pro7it/hexapod/hexapod_rl/IO.md

# Вхід і вихід політики

## Вхід (спостереження): N = 66

| # | Що | Розмір | Індекси | Джерело в MuJoCo | Джерело на реальному роботі |
|---|---|---|---|---|---|
| 1 | Кути суглобів мінус поза стояння | 18 | 0-17 | `qpos[7:]` | енкодер/потенціометр серво |
| 2 | Швидкості суглобів (×0.05) | 18 | 18-35 | `qvel[6:]` | різниця кутів / dt |
| 3 | Вектор гравітації в системі корпусу | 3 | 36-38 | кватерніон `imu_quat` -> поворот `[0,0,-1]` | фільтр (акселерометр + гіроскоп) |
| 4 | Гіроскоп (кутова швидкість корпусу) | 3 | 39-41 | `imu_gyro` | гіроскоп IMU |
| 5 | Попередня дія | 18 | 42-59 | збережена в env | збережена в коді |
| 6 | Контакти стоп (0..1) | 6 | 60-65 | `l1_touch` ... `r3_touch` | кінцеві вимикачі |
| | **Разом** | **66** | | | |

Пізніше, для керованого руху, додається команда швидкості
(vx, vy, yaw rate): +3, тобто N = 69.

Не входить у спостереження (тільки для reward і завершення епізоду):
висота корпусу `qpos[2]`, лінійна швидкість `qvel[0:3]`, позиція x, y.
На реальному роботі їх немає.

## Вихід (дія): 18

| # | Що | Розмір | Діапазон |
|---|---|---|---|
| 1 | Нормалізована зміна цільового кута кожного серво | 18 | [-1, 1] |

Порядок: l1, l2, l3, r1, r2, r3, у кожній нозі coxa, femur, tibia
(як актуатори в `hexapod.xml`).

Перетворення в `step()`:

```
target = clip(target + ACTION_SCALE * action, -1.57, 1.57)   # ACTION_SCALE = 0.03 рад
data.ctrl[:] = target
```

При 50 Гц це до 1.5 рад/с на суглоб.

## Чому не можна просто взяти IMU як кватерніон

1. **Звичайний IMU не дає кватерніон.** Модулі типу MPU6050/MPU6500
   видають лише сирі акселерометр (3) і гіроскоп (3). Кватерніон треба
   обчислювати самому фільтром (Madgwick, Mahony, комплементарний).
   У MuJoCo `imu_quat` це ідеальна істина, якої на залізі не буде.
   Є IMU з вбудованим фьюжном (BNO055, BNO085), але в них свої проблеми
   (див. п. 3).

2. **Кватерніон містить yaw, а політиці він шкідливий.** Напрямок, куди
   дивиться робот у світі, не має впливати на те, як переставляти ноги.
   Якщо подати кватерніон, мережа вчиться залежати від курсу і гірше
   узагальнюється.

3. **Yaw неможливо виміряти без магнітометра.** Гіроскоп інтегрується, і
   yaw дрейфує. Акселерометр визначає тільки нахил і крен (де «низ»).
   Магнітометр у приміщенні та поруч з серво ненадійний. Тому на залізі
   можна надійно знати лише гравітацію, а не повну орієнтацію.

4. **Подвійне покриття.** Кватерніони `q` і `-q` описують той самий
   поворот, тож однакова поза може давати різні входи. Для нейромережі
   це розрив у даних (стрибки знака).

5. **Акселерометр під час руху шумний.** Він вимірює гравітацію плюс
   прискорення корпусу. Походка дає вібрації, тому сирий акселерометр як
   «напрямок гравітації» брехливий, і потрібен фільтр. У симуляторі варто
   додати такий шум до гравітації, щоб політика не звикла до ідеалу.

**Рішення:** подавати вектор гравітації в системі корпусу (3 числа).
Він показує нахил і крен, не залежить від yaw, не має подвійного
покриття і оцінюється на залізі з акселерометра та гіроскопа.

Обчислення в симуляторі:

```
q = data.sensordata[<адреса imu_quat>]   # w, x, y, z
q_inv = mju_negQuat(q)
g_body = mju_rotVecQuat([0, 0, -1], q_inv)
```
