pro7it/hexapod/references/details.md

| Категорія | Товар | К-сть | Ціна (прибл.) | Навіщо саме тобі |
| --- | --- | --- | --- | --- |
| Мозок (основний) | Raspberry Pi 4 (4GB) | 1 | $85-100 | Веб-сервер, Python-код керування, база під ROS2 у майбутньому |
| Карта пам'яті | microSD 32GB, клас A1/A2 | 1 | $8-10 | ОС для Pi (Raspberry Pi OS / Ubuntu Server) |
| Драйвер серво | PCA9685 16-channel I2C PWM | 2 | ~$9-10/шт ($18-20) | Генерує стабільний PWM для 18 серв — Pi сам на таке не здатен |
| АЦП для сенсорів | ADS1115 4-channel I2C ADC | 1 | $8-10 | Обов'язково, бо Pi не має аналогових пінів |
| Струм/напруга | ACS712 30A + Voltage Sensor DC0-25V | 1 (набір)  | $12 | Моніторинг споживання і напруги батареї з коду |
| Лімсвічі | Micro Limit Switch (30 шт, потрібно 6) | 1 упаковка | $4.99 | Кінцевики ходу ніг, йдуть у надруковану деталь micro-switch-tip |
| Дроти | Dupont F-F 120 шт | 4 | $6.98 | I2C, GPIO, живлення сенсорів |
| Сервоприводи | ZOSKAY 35kg High Torque | 18 | ~$18-20/шт (~$330-360) | Виконавчі механізми всіх 18 суглобів |
| Тестер сервоприводів | ACOSUN Digital Servo Tester | 1 | $12.99 | Калібрування кожної з 18 однакових серв перед збіркою |
| Батарея для тестера | NiMH 4.8V 2000mAh | 1 | $11.99 | Живлення тестера окремо від головної батареї |
| Батарея | Zeee 7.4V 60C 6200mAh 2S LiPo | 1 | ~$22 | Живлення сервоприводів |
| Понижувач напруги | DC-DC buck converter 7.4V→5V, 3A+ | 1 | $7-10 | Живлення Pi від тієї ж батареї — 7.4V напряму спалить плату |
| Вимикач | Mini Toggle Switch SPST (набір 10 шт)  | 1 | $9.99 | Головний вимикач живлення |
| Силовий роз'єм | Deans/T-plug (5 пар) | 1 | $8.99 | Стандартний конектор під LiPo |
| Зарядка | Tenergy TB6-B Balance Charger | 1 | $57.99 | Безпечна зарядка LiPo 2S через баланс-роз'єм |
| Гумові наконечники | Rubber tips (5/16", 15мм) | 6 | $7.49 | Наконечники стоп |
| Дюбелі-обмежувачі | Dowel pins 2×22мм (100 шт, потрібно 6) | 1 упаковка | $6.59 | Механічні обмежувачі ходу в деталі limiter |
| Гвинти для 3D-деталей  | M1.6×6мм (100 шт, потрібно 120) | 2 упаковки | $15.74 | Кріплення надрукованих частин |
| Гвинти для плат | M2.5×6мм (100 шт, потрібно 4) | 1 упаковка | $10.99 | Кріплення PCA9685/ADS1115 |
| Суперклей | Gorilla Super Glue Gel | 1 | $6.84 | Фіксація дюбелів-обмежувачів |
| Маркери | Sharpie metallic fine point | 1 | $3.48 | Мітки на сервоприводах під час калібрування |
| Паяльник | Soldering Iron Kit 60W | 1 | $22.99 | Пайка вимикача, силових проводів |
| Термофен (опціонально) | Heat gun | 1 | $21.22 | Термоусадка на з'єднаннях |
| LiDAR | RPLidar A1 | 1 | ~$100 | SLAM — побудова карти, виявлення перешкод для Nav2 |
| IMU | BNO055 (I2C) | 1 | ~$12 | Орієнтація тіла |
