pro7it/hexapod/references/3dparts.md

| Part | Description | Amount | File |
| --- | --- | --- | --- |
| battery bar | hold battery | 2 | `battery-bar.stl` |
| bottom cover | hold all electronics  | 1 | `bottom-cover.stl` |
| frame | the holding one | 1 | `frame.stl` |
| top cover | close the electronics | 1 | `top-cover.stl` |
| left coxa | leg component | 3 | `left-coxa.stl` |
| right coxa | leg component | 3 | `right-coxa.stl` |
| left femur | leg component | 3 | `left-femur.stl` |
| right femur | leg component | 3 | `right-femur.stl` |
| left tibia | leg component | 3 | `left-tibia.stl` |
| right tibia | leg component | 3 | `right-tibia.stl` |
| limiter | leg component | 6 | `limiter.stl` |
| micro switch tip | leg component | 6 | `micro-switch-tip.stl`  |
| tip | leg component | 6 | `tip.stl` |
| servo back hole  | leg component | 18 | `servo-back-hole.stl` |
| shield | leg protection | 6 | `shield.stl` |
| calibrator arm | check servo | 1 | `calibration-arm.stl` |
| calibrator ruler | check servo | 1 | `calibration-ruler.stl` |
