pro7it/hexapod/model_report.md

# Гексапод: RL-модель ходи (stage3.3-sway)

*Станом на 2 листопада 2026*

Модель stage3.3-sway — нейромережева політика, навчена методом PPO. Вона керує 18 суглобами гексапода в симуляторі MuJoCo і ходить триногою вперед зі швидкістю 0.18 м/с. Заданий курс робот тримає з похибкою 0.15°, а вбік майже не зсувається (−0.6 см на метр). Політику навчено з нуля за 5 млн кроків симуляції лише через нагороди і штрафи, без заданої наперед траєкторії ніг.

Файли моделі: `hexapod_rl/models/stage3.3-sway/model.zip` і `vecnormalize.pkl` (статистика нормалізації спостережень).

## Задача і симуляція

| параметр | значення |
| --- | --- |
| робот | гексапод, 6 ніг × 3 суглоби (coxa, femur, tibia) = 18 ступенів свободи |
| маса моделі | 2.23 кг |
| симулятор | MuJoCo, крок фізики 2 мс |
| приводи | позиційні: kp = 20, kv = 0.5, момент до ±3.4 Н·м, діапазон суглобів ±45° |
| частота керування | 50 Гц (10 кроків фізики на одну дію) |
| епізод | 1000 кроків = 20 с; завершується, якщо корпус нижче 5 см або перевернувся |
| середовище | Gymnasium; код: `hexapod_rl/hexapod_env.py`, параметри: `hexapod_rl/config.py` |

## Спостереження і дії

**Спостереження: 45 чисел.**

| частина | розмір | опис |
| --- | --- | --- |
| кути суглобів | 18 | відхилення від стійки (STAND_POSE) |
| швидкості суглобів | 18 | × 0.05 |
| вектор гравітації в осях корпусу | 3 | нахил корпусу (IMU) |
| кутова швидкість корпусу | 3 | гіроскоп (IMU) |
| фаза ходи | 2 | sin і cos фази, генератор ритму 1.5 Гц |
| похибка курсу | 1 | заданий курс мінус поточний, у радіанах |

Спостереження нормалізуються ковзним середнім і дисперсією (VecNormalize) з обрізанням до ±10.

**Дія: 18 чисел у [−1, 1].** Кожне задає зсув кута суглоба від стійки до ±0.5 рад. Перед подачею на приводи ціль згладжується фільтром нижніх частот:

```latex
\theta_t = 0.8\,\theta_{t-1} + 0.2\,(\theta_{stand} + 0.5\,a_t)
```

**Фаза** не задає рух ніг, а лише дає мережі «годинник» ритму. Нагорода за ходу перевіряє, чи стопи торкаються землі за розкладом триноги: тринога A (l1, r2, l3) стоїть, коли sin фази > 0, тринога B (r1, l2, r3) — навпаки.

**Курс:** при кожному скиданні ціль = стартовий курс + випадковий зсув до ±15°, тож модель вчиться і довертати на курс, і тримати його.

## Нагорода

Нагорода на кожному кроці — зважена сума 12 термів.

| терм | вага | що вимірює | навіщо |
| --- | --- | --- | --- |
| r_vel | +2.0 | швидкість уперед / 0.15 м/с, обрізано до [−1, 1] | основна мета; стеля прибирає «вібраційний» розгін |
| r_gait | +1.0 | частка ніг, чий контакт із землею збігається з розкладом триноги | ритм триноги |
| r_heading | +1.0 | exp(−Δψ² / 0.0076), σ ≈ 5° | тримати заданий курс |
| r_vy | +1.0 | exp(−v̄y² / 0.0001), бічна швидкість, усереднена за цикл | не рухатися крабом |
| r_air | +1.0 | при приземленні: час у повітрі − 0.2 с (до 0.5 с) | справжні кроки замість дрібного тупцювання |
| pen_roll | −100 | квадрат нахилу корпусу вбік | рівний корпус |
| pen_pitch | −30 | квадрат нахилу корпусу вперед-назад | рівний корпус |
| pen_stroke | −20 | раз на півцикл: дисперсія довжини ходу 6 стоп навколо середнього | усі шість ніг крокують однаково |
| pen_angvel | −2 | ωx² + ωy² + ωz² корпусу | без хитання і виляння |
| pen_vy | −20 | бічна швидкість² на кожному кроці | без розгойдування вліво-вправо |
| pen_vz | −50 | вертикальна швидкість² | без підскакування |
| pen_rate | −0.05 | Σ(aₜ − aₜ₋₁)² | плавні дії, без вібрації |

Окремі терми з'являлися у відповідь на конкретні обхідні шляхи, які знаходив PPO: рух за рахунок вібрації (r_vel зі стелею, pen_rate, r_air), ходьба на кількох ногах, поки решта відпочиває (pen_stroke), дрейф курсу (r_heading), рух крабом (r_vy, pen_vy).

## Навчання

| параметр | значення |
| --- | --- |
| алгоритм | PPO (Stable-Baselines3), MlpPolicy |
| мережі | актор і критик окремі, по два шари 256 нейронів |
| паралельні середовища | 4 |
| n_steps / batch_size / n_epochs | 1024 / 2048 / 5 |
| γ / λ (GAE) / clip | 0.99 / 0.95 / 0.2 |
| швидкість навчання | 3·10⁻⁴ → 3·10⁻⁵ лінійно за перші 3 млн кроків, далі стала 3·10⁻⁵ |
| дослідження | log_std_init = −1, ent_coef = 0 |
| тривалість | 3 млн кроків з нуля + 2 млн донавчання = 5 млн (≈ 28 год симульованого часу) |

## Результати

Оцінка без шуму дій (deterministic), 6 запусків по 20 с:

| метрика | значення |
| --- | --- |
| швидкість уперед | 0.179 м/с |
| довертання з похибки курсу до 15° | 0.4 с |
| похибка курсу після довертання | 0.15° (максимум 0.4°) |
| бічний зсув | −0.6 см на метр |
| нахил корпусу вбік (roll) | ±0.15° |
| виляння (ωz) | ±0.041 рад/с |
| хода | тринога з ритмом 1.5 Гц; контакт стоп збігається з розкладом у 88% випадків |

Тест на стійкість (ті самі метрики, 3 запуски на умову, жодного падіння):

| умова | швидкість, м/с | похибка курсу після 5 с |
| --- | --- | --- |
| номінальна | 0.179 | 0.15° |
| тертя × 0.6 | 0.170 | 0.18° |
| тертя × 1.4 | 0.055 | 0.59° |
| маса корпусу × 1.3 | 0.177 | 0.14° |
| маса корпусу × 0.8 | 0.180 | 0.16° |
| поштовх убік 25 Н, 0.1 с | 0.178 | 0.18° |
| поштовх назад 25 Н, 0.1 с | 0.174 | 0.18° |

## Обмеження і наступні кроки

- **Шаркання.** Стопи піднімаються лише на 3–6 мм, а 12% часу в «повітряній» фазі торкаються землі. Через це на липкішій підлозі (тертя × 1.4) швидкість падає втричі. План: нагорода за підйом ноги і випадкове тертя під час навчання.
- **Датчики справжнього робота.** На роботі стоять PWM-сервоприводи без зворотного зв'язку, тож фактичних кутів і швидкостей суглобів у спостереженні не буде. Наступна версія вчиться на скомандованих кутах і попередній дії замість них (у роботі). Далі в планах контакти стоп від кінцевиків.
- **Перенесення на залізо.** Потрібно заміряти динаміку серво, додати затримки, шум IMU і випадкові зміни маси й тертя.
- **Команди.** Наступний етап — керування швидкостями (vx, vy, ω) замість фіксованого руху вперед.
