pro7it/hexapod/hexapod_rl/model/meshes/right-femur.stl

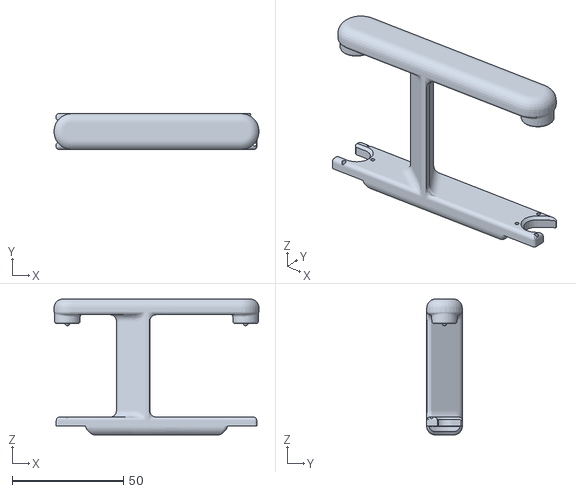
[picture p1: CAD file, 2026-11-04]
hexapod_rl/model/meshes/right-femur.stl
92.0 x 16.0 x 61.0
