pro7it/hexapod/hexapod_ws/src/hexapod_description/meshes/left-coxa.stl

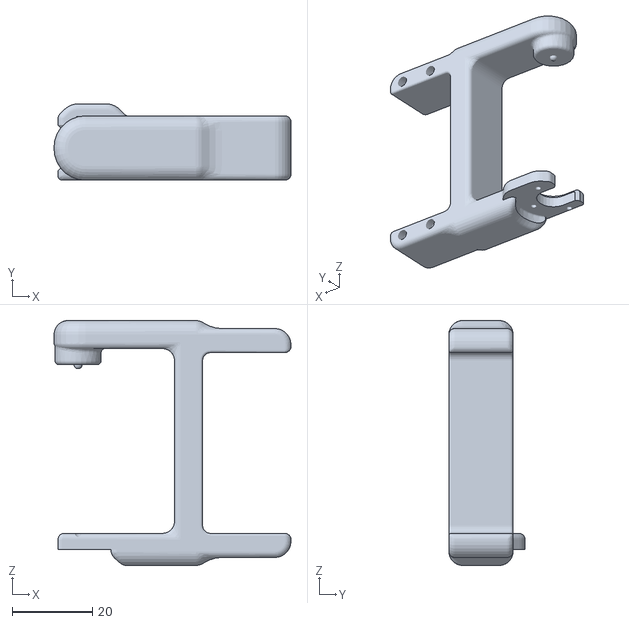
[picture p2: CAD file, 2026-11-04]
hexapod_ws/src/hexapod_description/meshes/left-coxa.stl
59.0 x 19.0 x 61.0
