pro7it/hexapod/references/stl/limiter.stl

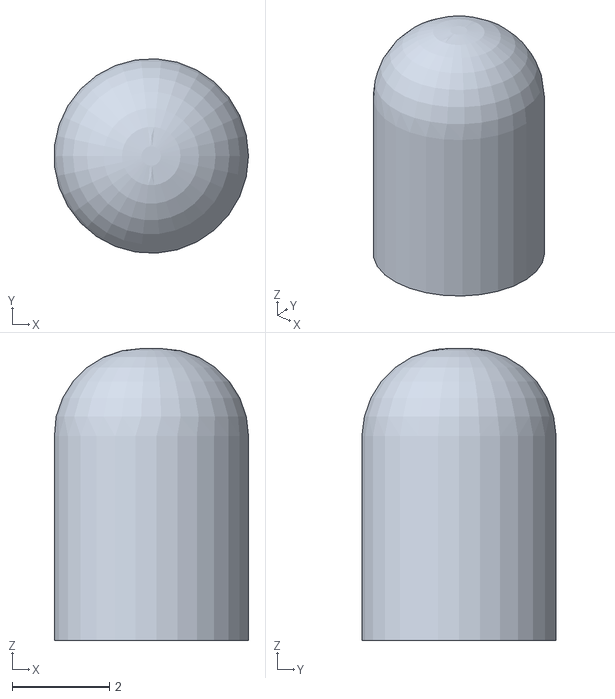
[picture p3: CAD file, 2026-09-18]
references/stl/limiter.stl
3.99 x 3.99 x 6.00
