pro7it/hexapod/stl_decimate/top-cover.stl

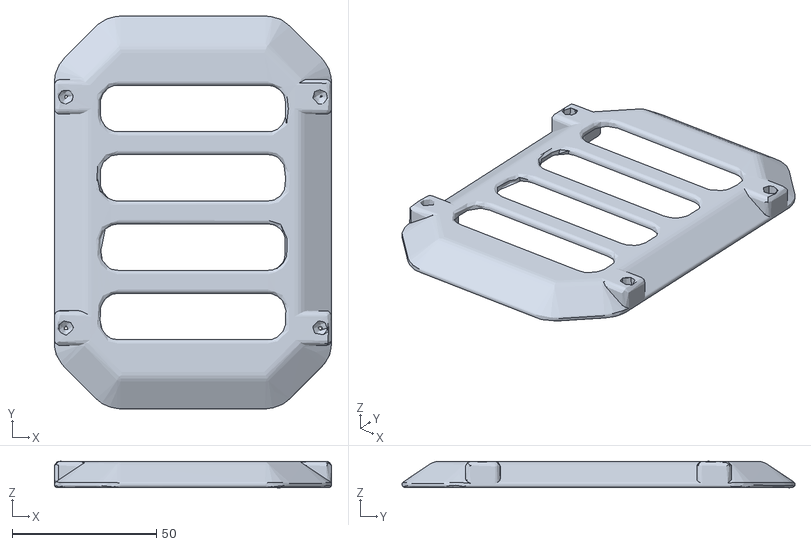
[picture p4: CAD file, 2026-10-15]
stl_decimate/top-cover.stl
96.0 x 136.0 x 9.21
