pro7it/hexapod/hexapod_ws/src/hexapod_description/meshes/right-coxa-collision.stl

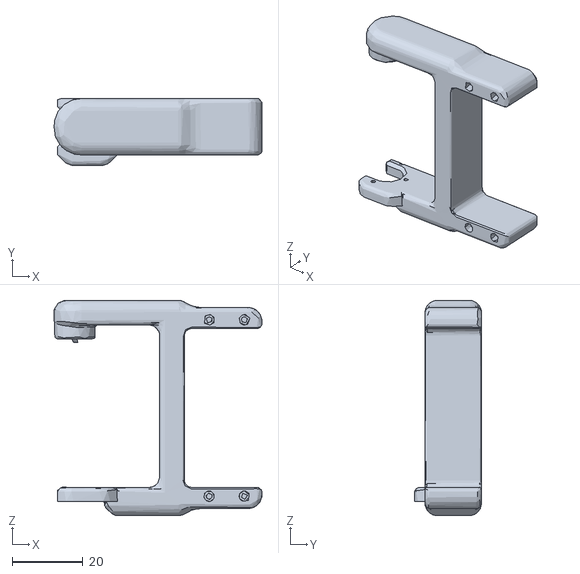
[picture p5: CAD file, 2026-11-04]
hexapod_ws/src/hexapod_description/meshes/right-coxa-collision.stl
58.9 x 19.0 x 61.0
