pro7it/hexapod/references/stl/left-coxa.stl

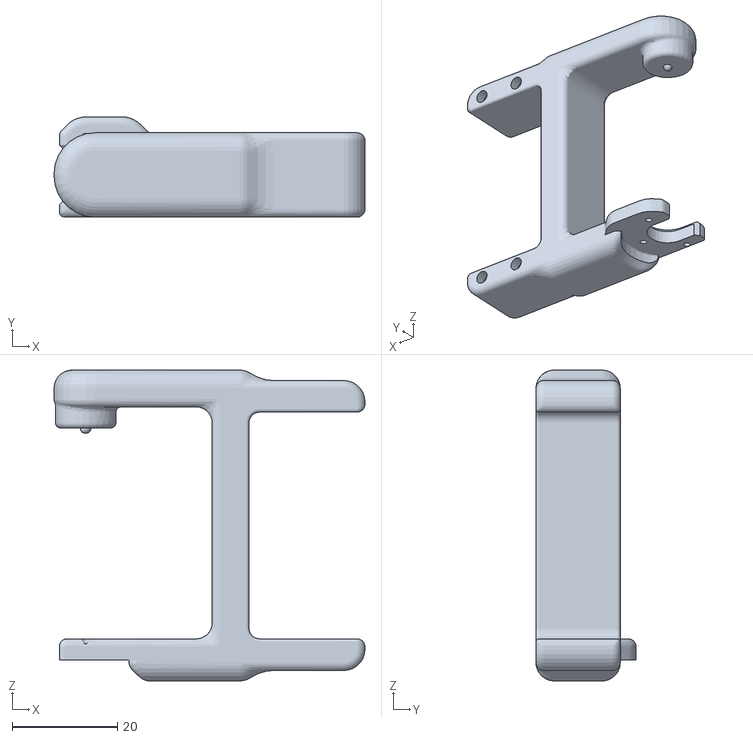
[picture p6: CAD file, 2026-09-18]
references/stl/left-coxa.stl
59.0 x 19.0 x 59.0
