pro7it/hexapod/stl_decimate/servo-back-hole.stl

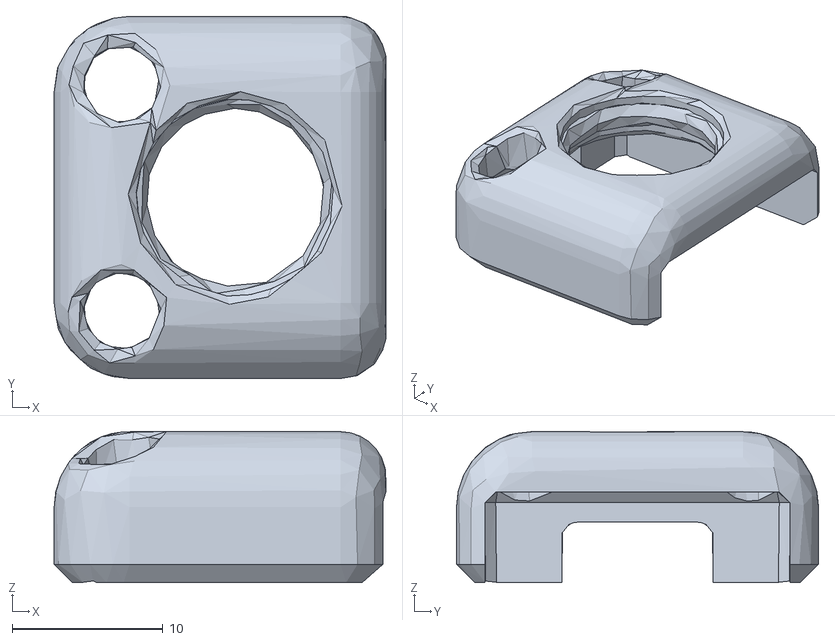
[picture p7: CAD file, 2026-10-15]
stl_decimate/servo-back-hole.stl
22.0 x 24.0 x 10.0
