pro7it/hexapod/references/stl/shield.stl

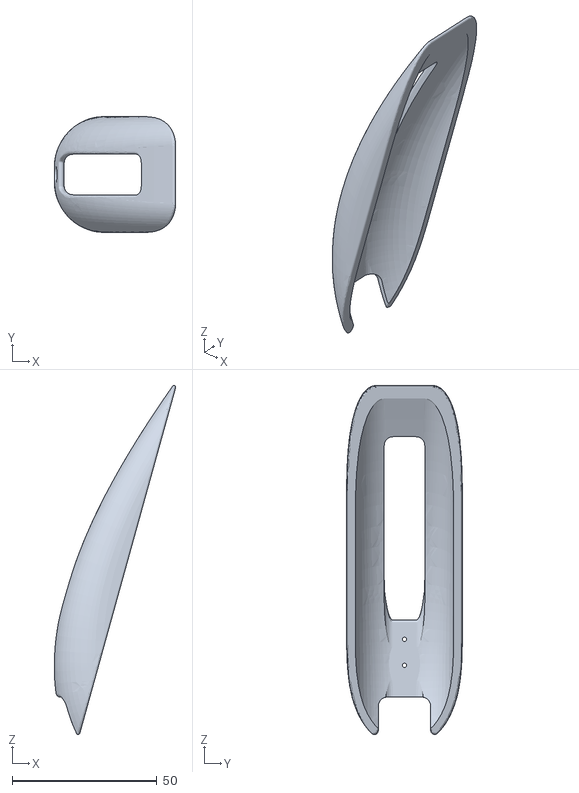
[picture p8: CAD file, 2026-09-18]
references/stl/shield.stl
42.0 x 40.0 x 120.6
