pro7it/hexapod/stl_decimate/right-femur.stl

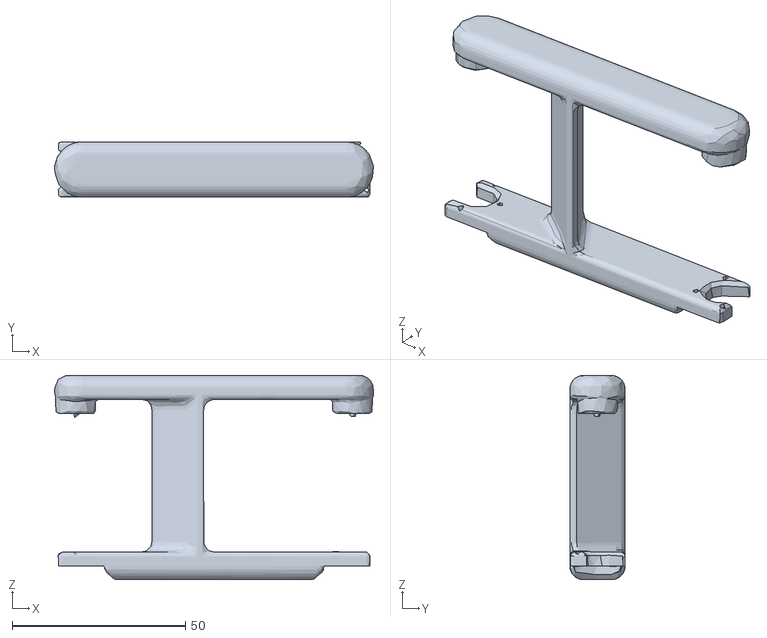
[picture p9: CAD file, 2026-10-15]
stl_decimate/right-femur.stl
92.1 x 16.0 x 59.0
