pro7it/hexapod/hexapod_ws/src/hexapod_description/meshes/tip-collision.stl

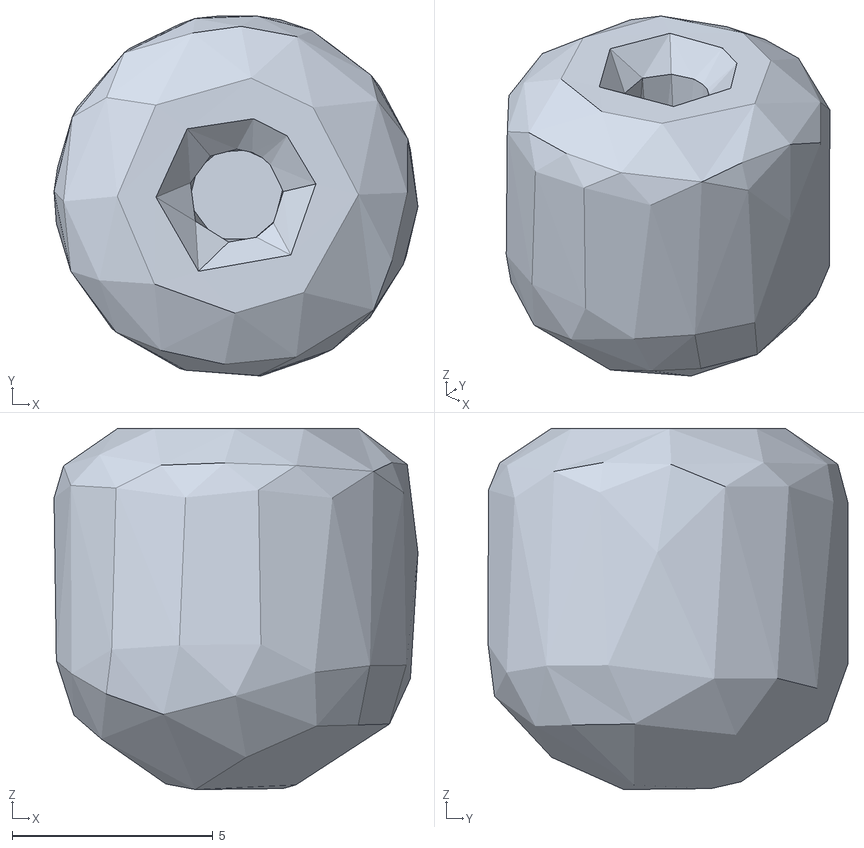
[picture p10: CAD file, 2026-10-15]
hexapod_ws/src/hexapod_description/meshes/tip-collision.stl
9.06 x 8.96 x 8.99
