pro7it/hexapod/references/stl/micro-switch-tip.stl

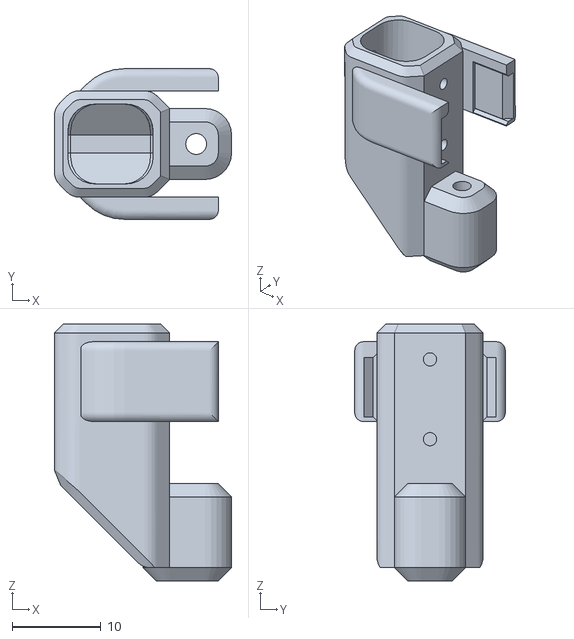
[picture p11: CAD file, 2026-09-18]
references/stl/micro-switch-tip.stl
20.0 x 17.0 x 29.0
