pro7it/hexapod/stl_decimate/right-tibia.stl

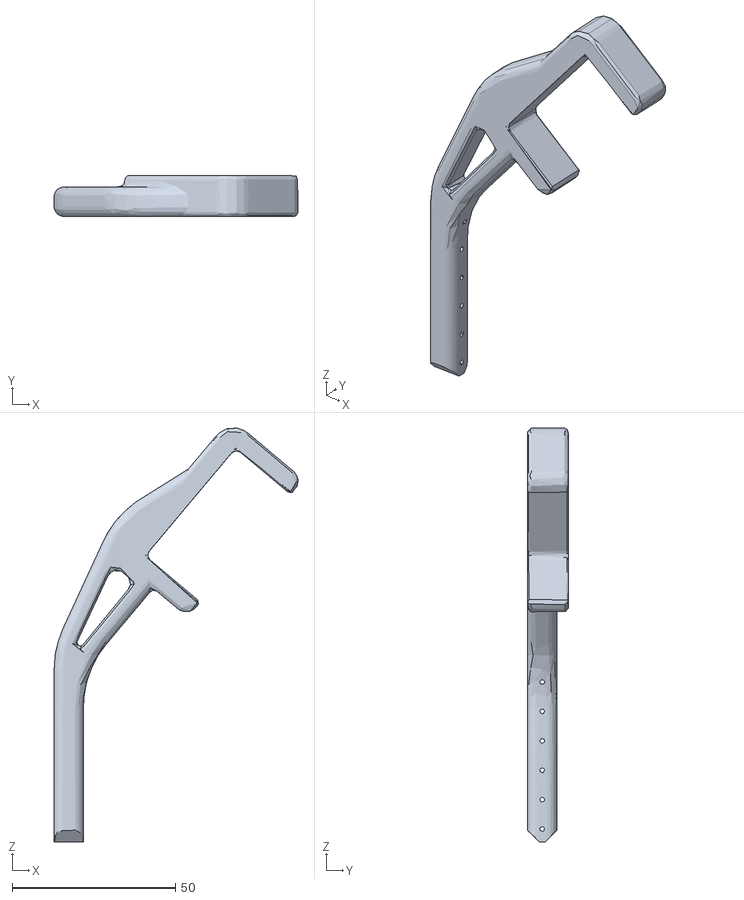
[picture p12: CAD file, 2026-10-15]
stl_decimate/right-tibia.stl
74.6 x 12.5 x 126.7
