pro7it/hexapod/hexapod_ws/src/hexapod_description/meshes/micro-switch-tip-collision.stl

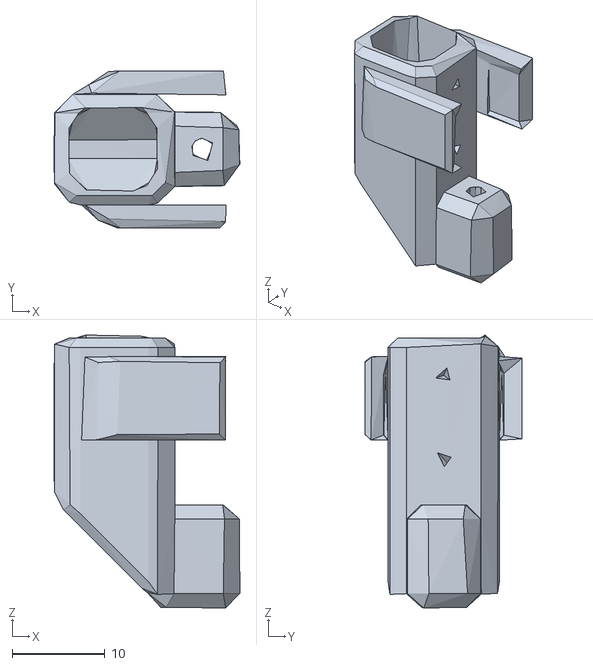
[picture p13: CAD file, 2026-10-15]
hexapod_ws/src/hexapod_description/meshes/micro-switch-tip-collision.stl
20.0 x 16.9 x 29.4
