pro7it/hexapod/references/stl/tip.stl

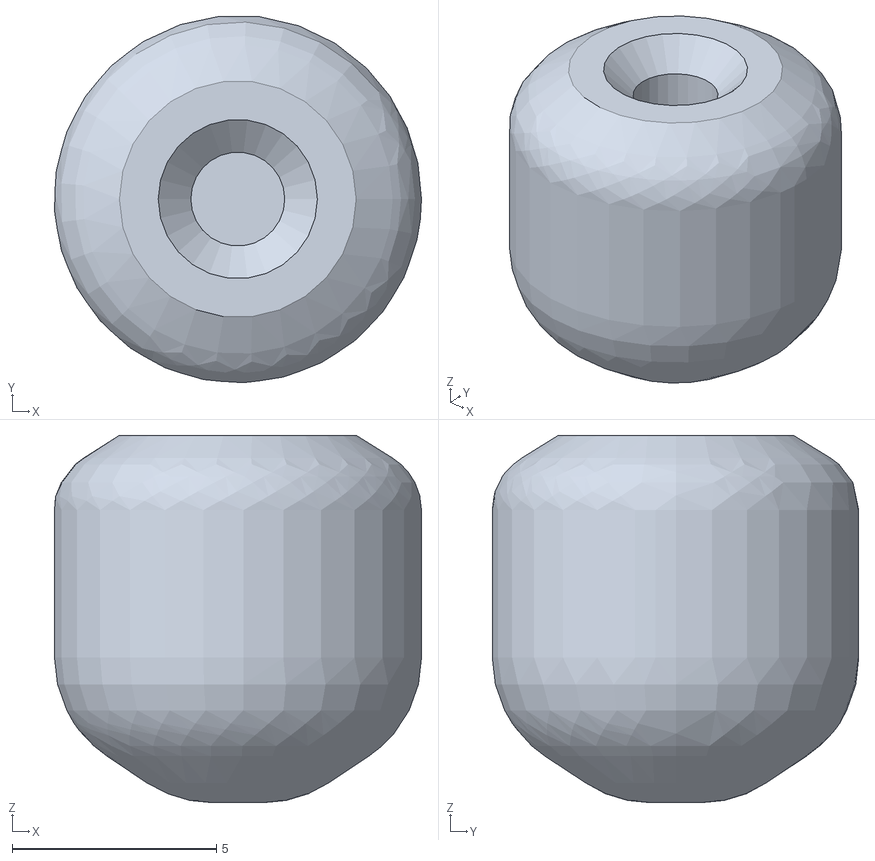
[picture p14: CAD file, 2026-09-18]
references/stl/tip.stl
8.99 x 8.98 x 9.00
