pro7it/hexapod/stl_decimate/calibration-ruler.stl

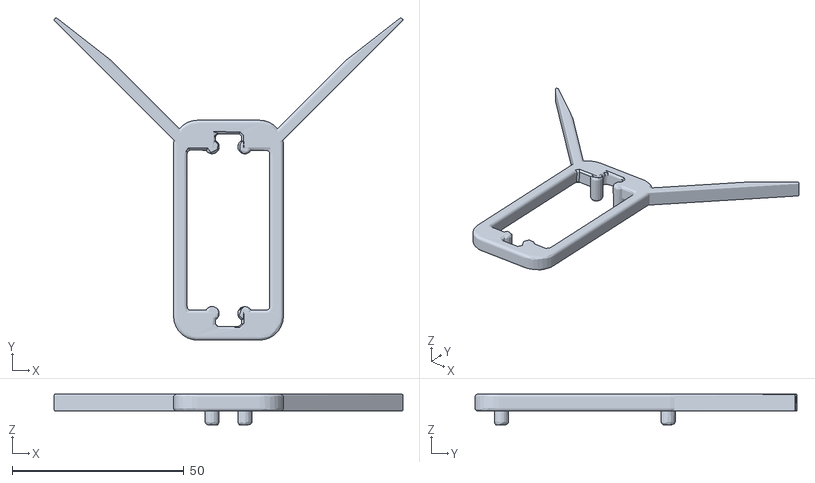
[picture p15: CAD file, 2026-10-15]
stl_decimate/calibration-ruler.stl
101.5 x 93.8 x 9.01
