pro7it/hexapod/hexapod_ws/src/hexapod_description/meshes/battery-bar-collision.stl

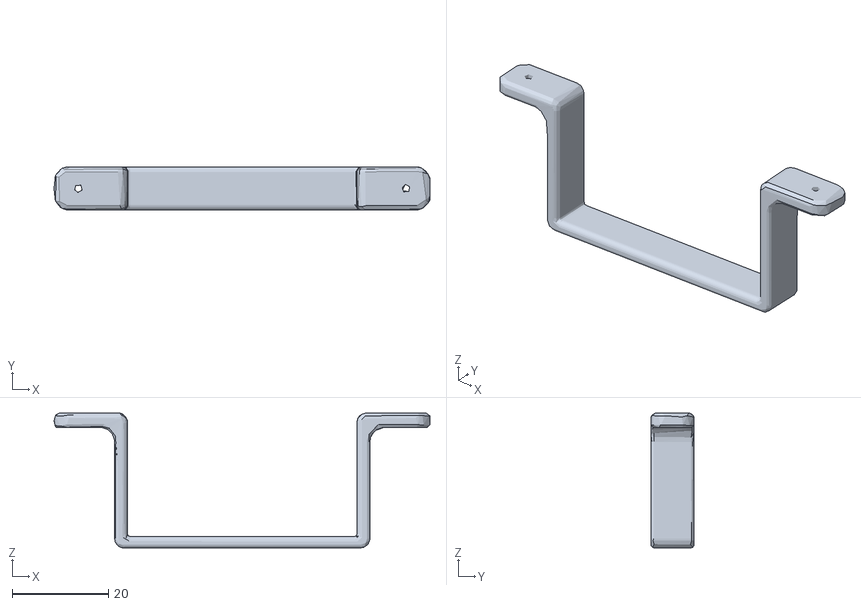
[picture p16: CAD file, 2026-10-15]
hexapod_ws/src/hexapod_description/meshes/battery-bar-collision.stl
78.0 x 9.00 x 28.0
