pro7it/hexapod/hexapod_ws/src/hexapod_description/meshes/frame-collision.stl

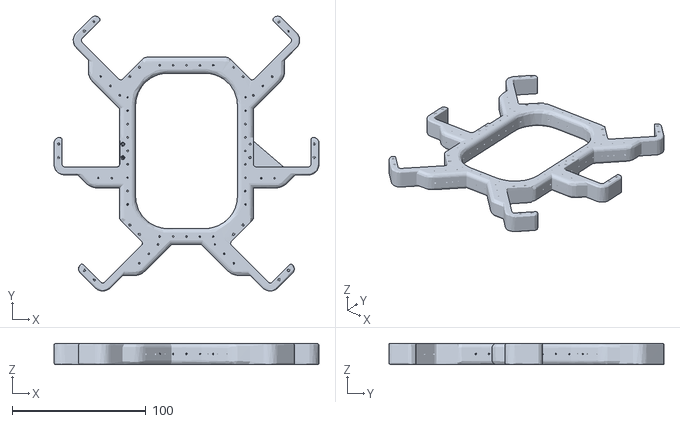
[picture p17: CAD file, 2026-10-15]
hexapod_ws/src/hexapod_description/meshes/frame-collision.stl
198.0 x 205.4 x 16.0
