pro7it/hexapod/stl_decimate/calibration-arm.stl

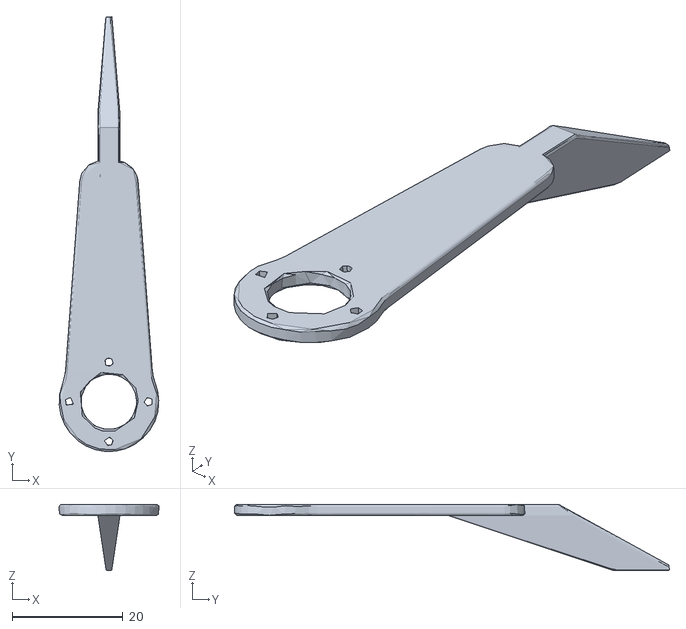
[picture p18: CAD file, 2026-10-15]
stl_decimate/calibration-arm.stl
18.0 x 78.5 x 12.0
