pro7it/hexapod/hexapod_ws/src/hexapod_description/meshes/bottom-cover-collision.stl

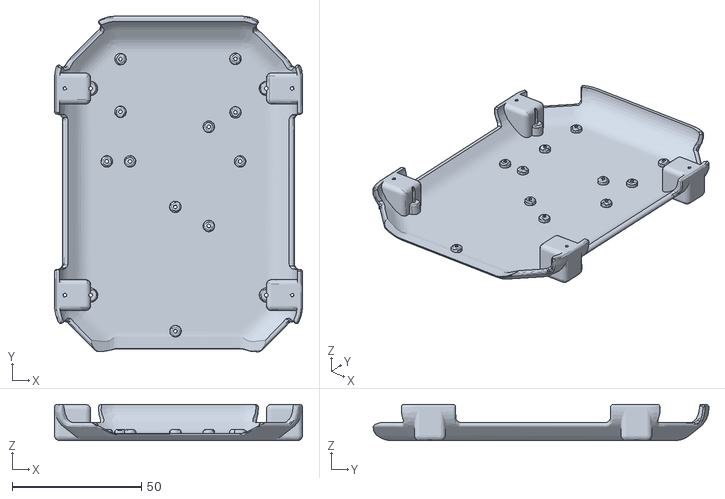
[picture p19: CAD file, 2026-10-15]
hexapod_ws/src/hexapod_description/meshes/bottom-cover-collision.stl
96.0 x 130.0 x 14.0
