pro7it/hexapod/references/stl/top-cover.stl

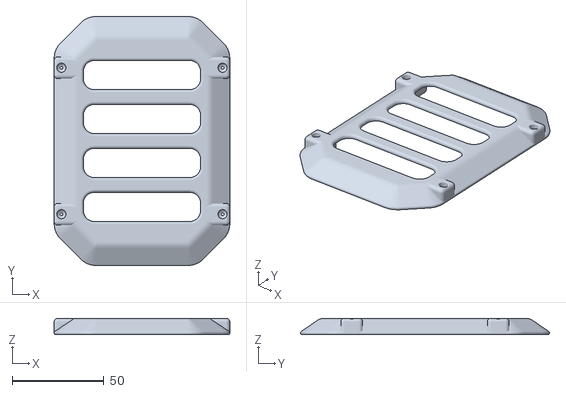
[picture p20: CAD file, 2026-09-18]
references/stl/top-cover.stl
96.0 x 136.0 x 9.00
