pro7it/hexapod/references/stl/frame.stl

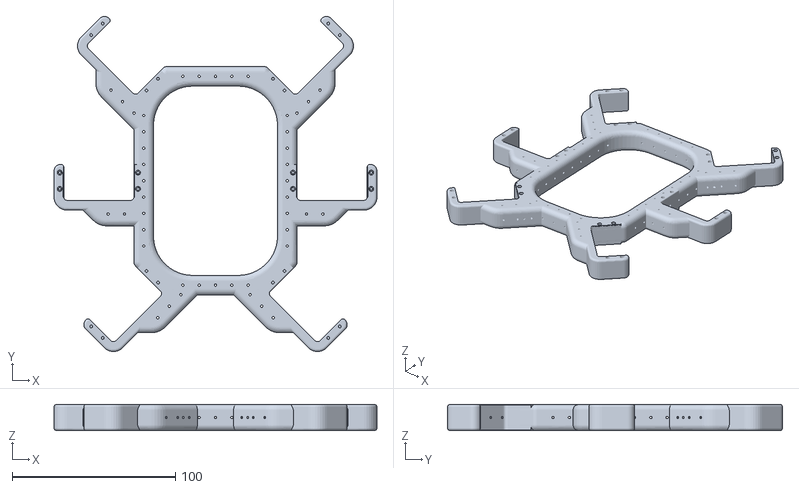
[picture p21: CAD file, 2026-09-18]
references/stl/frame.stl
198.0 x 205.4 x 16.0
