pro7it/hexapod/references/stl/calibration-arm.stl

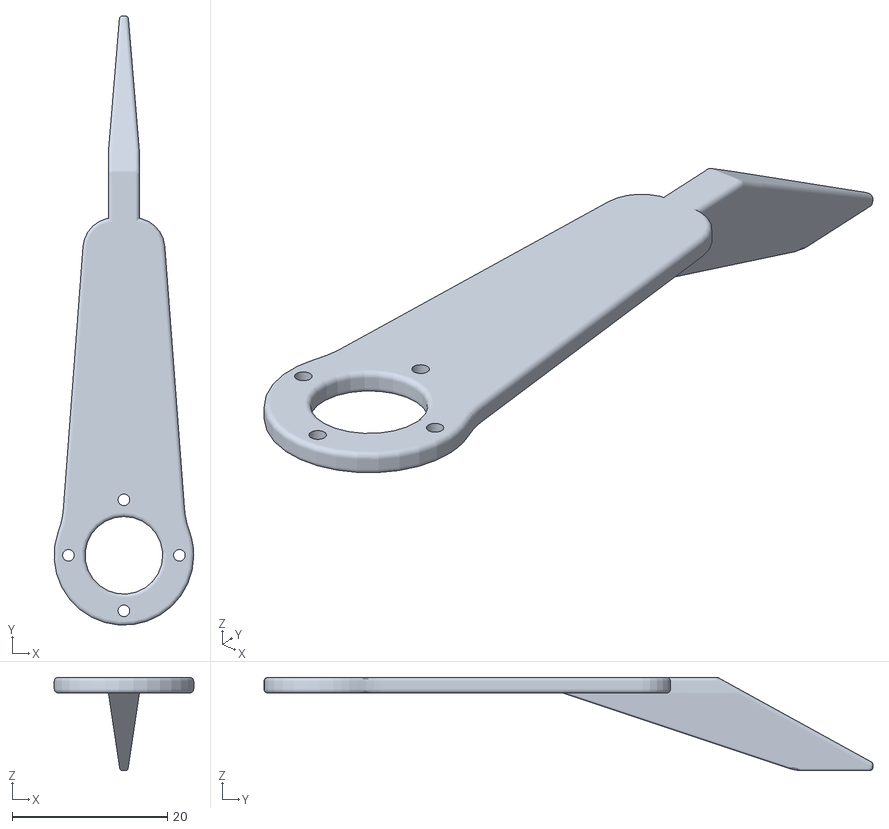
[picture p22: CAD file, 2026-09-18]
references/stl/calibration-arm.stl
18.0 x 78.5 x 12.0
