pro7it/hexapod/(list of files, cad)

Other CAD files:
stl/left-femur.stl
hexapod_rl/model/meshes/right-coxa.stl
hexapod_ws/src/hexapod_description/meshes/right-femur-collision.stl
hexapod_ws/src/hexapod_description/meshes/left-femur-collision.stl
references/stl/right-femur.stl
stl_decimate/shield.stl
hexapod_ws/src/hexapod_description/meshes/left-coxa-collision.stl
references/stl/right-coxa.stl
stl_decimate/limiter.stl
references/stl/left-femur.stl
stl_decimate/left-coxa.stl
references/stl/left-tibia.stl
references/stl/servo-back-hole.stl
hexapod_ws/src/hexapod_description/meshes/left-tibia-collision.stl
references/stl/right-tibia.stl
references/stl/calibration-ruler.stl
references/stl/bottom-cover.stl
references/stl/battery-bar.stl
