pro7it/hexapod/hexapod_rl/model/hexapod.urdf

<?xml version="1.0" ?>
<!-- =================================================================================== -->
<!-- |    This document was autogenerated by xacro from hexapod_ws/src/hexapod_description/urdf/hexapod.urdf.xacro | -->
<!-- |    EDITING THIS FILE BY HAND IS NOT RECOMMENDED                                 | -->
<!-- =================================================================================== -->
<robot name="hexapod">
  <mujoco>
    <compiler meshdir="meshes" fusestatic="false" discardvisual="false" balanceinertia="true"/>
  </mujoco>
  <link name="base_link">
    <visual>
      <geometry>
        <mesh filename="frame.stl" scale="0.001 0.001 0.001"/>
      </geometry>
      <origin rpy="0 0 0" xyz="0 0 0"/>
      <material name="dark_grey">
        <color rgba="0.2 0.2 0.2 1.0"/>
      </material>
    </visual>
    <collision>
      <geometry>
        <box size="0.198 0.205 0.016"/>
      </geometry>
      <origin rpy="0 0 0" xyz="0 0 0"/>
    </collision>
    <inertial>
      <origin rpy="0 0 0" xyz="-0.00002 -0.00106 0.00800"/>
      <mass value="0.4864"/>
      <inertia ixx="1.763e-03" ixy="-5.177e-08" ixz="5.397e-10" iyy="1.708e-03" iyz="2.214e-09" izz="3.371e-03"/>
    </inertial>
  </link>
  <link name="top_cover_link">
    <visual>
      <geometry>
        <mesh filename="top-cover.stl" scale="0.001 0.001 0.001"/>
      </geometry>
      <origin rpy="0 0 0" xyz="0 0 0.0125"/>
      <material name="orange">
        <color rgba="1.0 0.5 0.0 1.0"/>
      </material>
    </visual>
    <inertial>
      <origin rpy="0 0 0" xyz="0.00000 -0.00000 0.04655"/>
      <mass value="0.1846"/>
      <inertia ixx="1.510e-04" ixy="1.687e-10" ixz="4.441e-11" iyy="2.034e-04" iyz="-1.877e-10" izz="2.428e-04"/>
    </inertial>
  </link>
  <joint name="top_cover_joint" type="fixed">
    <parent link="base_link"/>
    <child link="top_cover_link"/>
    <origin rpy="0 0 0" xyz="0 0 0.003"/>
  </joint>
  <link name="bottom_cover_link">
    <visual>
      <geometry>
        <mesh filename="bottom-cover.stl" scale="0.001 0.001 0.001"/>
      </geometry>
      <origin rpy="0 0 0" xyz="0 0 0.02"/>
      <material name="orange">
        <color rgba="1.0 0.5 0.0 1.0"/>
      </material>
    </visual>
    <inertial>
      <origin rpy="0 0 0" xyz="0.00054 0.00110 -0.01698"/>
      <mass value="0.4426"/>
      <inertia ixx="7.003e-04" ixy="-3.336e-06" ixz="-4.496e-06" iyy="1.982e-04" iyz="-2.872e-06" izz="7.458e-04"/>
    </inertial>
  </link>
  <joint name="bottom_cover_joint" type="fixed">
    <parent link="base_link"/>
    <child link="bottom_cover_link"/>
    <origin rpy="0 0 0" xyz="0 0 -0.003"/>
  </joint>
  <link name="l1_coxa_link">
    <visual>
      <geometry>
        <mesh filename="left-coxa.stl" scale="0.001 0.001 0.001"/>
      </geometry>
      <origin rpy="0 0 0" xyz="0 0 0"/>
      <material name="orange">
        <color rgba="1.0 0.5 0.0 1.0"/>
      </material>
    </visual>
    <inertial>
      <origin rpy="0 0 0" xyz="0.02964 0.00014 0.00625"/>
      <mass value="0.0771"/>
      <inertia ixx="1.617e-05" ixy="4.643e-08" ixz="6.122e-07" iyy="1.852e-05" iyz="-6.164e-08" izz="1.885e-05"/>
    </inertial>
  </link>
  <joint name="l1_coxa_joint" type="revolute">
    <parent link="base_link"/>
    <child link="l1_coxa_link"/>
    <origin rpy="0 0 2.35" xyz="-0.06 0.08 0.0"/>
    <axis xyz="0 0 1"/>
    <limit effort="3.4" lower="-1.57" upper="1.57" velocity="5.0"/>
    <dynamics damping="0.5" friction="0.05"/>
  </joint>
  <link name="l1_femur_link">
    <visual>
      <geometry>
        <mesh filename="left-femur.stl" scale="0.001 0.001 0.001"/>
      </geometry>
      <origin rpy="-1.57 0 0" xyz="0 0.01 0"/>
      <material name="orange">
        <color rgba="1.0 0.5 0.0 1.0"/>
      </material>
    </visual>
    <inertial>
      <origin rpy="0 0 0" xyz="0.06445 -0.00082 -0.00021"/>
      <mass value="0.0814"/>
      <inertia ixx="1.867e-05" ixy="-1.515e-06" ixz="-4.656e-07" iyy="2.912e-05" iyz="-7.096e-08" izz="4.288e-05"/>
    </inertial>
  </link>
  <joint name="l1_femur_joint" type="revolute">
    <parent link="l1_coxa_link"/>
    <child link="l1_femur_link"/>
    <origin rpy="0 -0.78 0" xyz="0.04 0 0.005"/>
    <axis xyz="0 1 0"/>
    <limit effort="3.4" lower="-1.57" upper="1.57" velocity="5.0"/>
    <dynamics damping="0.5" friction="0.05"/>
  </joint>
  <link name="l1_tibia_link">
    <visual>
      <geometry>
        <mesh filename="left-tibia.stl" scale="0.001 0.001 0.001"/>
      </geometry>
      <origin rpy="0 0 3.14" xyz="0.05 -0.005 0"/>
      <material name="orange">
        <color rgba="1.0 0.5 0.0 1.0"/>
      </material>
    </visual>
    <inertial>
      <origin rpy="0 0 0" xyz="0.02796 0.00030 -0.03451"/>
      <mass value="0.0112"/>
      <inertia ixx="1.178e-05" ixy="1.476e-07" ixz="5.850e-06" iyy="1.578e-05" iyz="-2.169e-07" izz="4.209e-06"/>
    </inertial>
  </link>
  <joint name="l1_tibia_joint" type="revolute">
    <parent link="l1_femur_link"/>
    <child link="l1_tibia_link"/>
    <origin rpy="0 0.078 0" xyz="0.08 0 0"/>
    <axis xyz="0 1 0"/>
    <limit effort="3.4" lower="-1.57" upper="1.57" velocity="5.0"/>
    <dynamics damping="0.5" friction="0.05"/>
  </joint>
  <link name="l1_shield_link">
    <visual>
      <geometry>
        <mesh filename="shield.stl" scale="0.001 0.001 0.001"/>
      </geometry>
      <origin rpy="0 0 3.14" xyz="0.04 0.005 0"/>
      <material name="orange">
        <color rgba="1.0 0.5 0.0 1.0"/>
      </material>
    </visual>
    <inertial>
      <origin rpy="0 0 0" xyz="0.02928 0.00052 -0.04358"/>
      <mass value="0.0098"/>
      <inertia ixx="1.094e-05" ixy="-6.245e-10" ixz="2.948e-06" iyy="1.025e-05" iyz="-6.117e-09" izz="3.014e-06"/>
    </inertial>
  </link>
  <joint name="l1_shield_joint" type="fixed">
    <parent link="l1_tibia_link"/>
    <child link="l1_shield_link"/>
    <origin rpy="0 0 0" xyz="0.01 0 0"/>
  </joint>
  <link name="l1_micro_switch_tip_link">
    <visual>
      <geometry>
        <mesh filename="micro-switch-tip.stl" scale="0.001 0.001 0.001"/>
      </geometry>
      <origin rpy="0 0 3.14" xyz="0 0 0"/>
      <material name="orange">
        <color rgba="1.0 0.5 0.0 1.0"/>
      </material>
    </visual>
    <inertial>
      <origin rpy="0 0 0" xyz="0.00621 -0.00001 0.02072"/>
      <mass value="0.0041"/>
      <inertia ixx="1.977e-07" ixy="2.657e-11" ixz="-4.968e-08" iyy="2.338e-07" iyz="5.395e-11" izz="1.167e-07"/>
    </inertial>
  </link>
  <joint name="l1_micro_switch_tip_joint" type="fixed">
    <parent link="l1_tibia_link"/>
    <child link="l1_micro_switch_tip_link"/>
    <origin rpy="0 0 0" xyz="0.04 0 -0.13"/>
  </joint>
  <link name="l1_tip_link">
    <visual>
      <geometry>
        <mesh filename="tip.stl" scale="0.001 0.001 0.001"/>
      </geometry>
      <origin rpy="0 0 0" xyz="0 0 0"/>
      <material name="orange">
        <color rgba="1.0 0.5 0.0 1.0"/>
      </material>
    </visual>
    <collision>
      <geometry>
        <sphere radius="0.005"/>
      </geometry>
      <origin rpy="0 0 0" xyz="0 0 0"/>
    </collision>
    <inertial>
      <origin rpy="0 0 0" xyz="0.00000 -0.00000 -0.00309"/>
      <mass value="0.0018"/>
      <inertia ixx="1.069e-08" ixy="6.542e-14" ixz="-2.181e-12" iyy="1.069e-08" iyz="3.638e-12" izz="2.687e-09"/>
    </inertial>
  </link>
  <joint name="l1_tip_joint" type="fixed">
    <parent link="l1_micro_switch_tip_link"/>
    <child link="l1_tip_link"/>
    <origin rpy="0 0 0" xyz="0 0 0"/>
  </joint>
  <gazebo reference="l1_tip_link">
    <mu1>1.0</mu1>
    <mu2>1.0</mu2>
  </gazebo>
  <link name="l2_coxa_link">
    <visual>
      <geometry>
        <mesh filename="left-coxa.stl" scale="0.001 0.001 0.001"/>
      </geometry>
      <origin rpy="0 0 0" xyz="0 0 0"/>
      <material name="orange">
        <color rgba="1.0 0.5 0.0 1.0"/>
      </material>
    </visual>
    <inertial>
      <origin rpy="0 0 0" xyz="0.02964 0.00014 0.00625"/>
      <mass value="0.0771"/>
      <inertia ixx="1.617e-05" ixy="4.643e-08" ixz="6.122e-07" iyy="1.852e-05" iyz="-6.164e-08" izz="1.885e-05"/>
    </inertial>
  </link>
  <joint name="l2_coxa_joint" type="revolute">
    <parent link="base_link"/>
    <child link="l2_coxa_link"/>
    <origin rpy="0 0 3.14" xyz="-0.08 0.0 0.0"/>
    <axis xyz="0 0 1"/>
    <limit effort="3.4" lower="-1.57" upper="1.57" velocity="5.0"/>
    <dynamics damping="0.5" friction="0.05"/>
  </joint>
  <link name="l2_femur_link">
    <visual>
      <geometry>
        <mesh filename="left-femur.stl" scale="0.001 0.001 0.001"/>
      </geometry>
      <origin rpy="-1.57 0 0" xyz="0 0.01 0"/>
      <material name="orange">
        <color rgba="1.0 0.5 0.0 1.0"/>
      </material>
    </visual>
    <inertial>
      <origin rpy="0 0 0" xyz="0.06445 -0.00082 -0.00021"/>
      <mass value="0.0814"/>
      <inertia ixx="1.867e-05" ixy="-1.515e-06" ixz="-4.656e-07" iyy="2.912e-05" iyz="-7.096e-08" izz="4.288e-05"/>
    </inertial>
  </link>
  <joint name="l2_femur_joint" type="revolute">
    <parent link="l2_coxa_link"/>
    <child link="l2_femur_link"/>
    <origin rpy="0 -0.78 0" xyz="0.04 0 0.005"/>
    <axis xyz="0 1 0"/>
    <limit effort="3.4" lower="-1.57" upper="1.57" velocity="5.0"/>
    <dynamics damping="0.5" friction="0.05"/>
  </joint>
  <link name="l2_tibia_link">
    <visual>
      <geometry>
        <mesh filename="left-tibia.stl" scale="0.001 0.001 0.001"/>
      </geometry>
      <origin rpy="0 0 3.14" xyz="0.05 -0.005 0"/>
      <material name="orange">
        <color rgba="1.0 0.5 0.0 1.0"/>
      </material>
    </visual>
    <inertial>
      <origin rpy="0 0 0" xyz="0.02796 0.00030 -0.03451"/>
      <mass value="0.0112"/>
      <inertia ixx="1.178e-05" ixy="1.476e-07" ixz="5.850e-06" iyy="1.578e-05" iyz="-2.169e-07" izz="4.209e-06"/>
    </inertial>
  </link>
  <joint name="l2_tibia_joint" type="revolute">
    <parent link="l2_femur_link"/>
    <child link="l2_tibia_link"/>
    <origin rpy="0 0.078 0" xyz="0.08 0 0"/>
    <axis xyz="0 1 0"/>
    <limit effort="3.4" lower="-1.57" upper="1.57" velocity="5.0"/>
    <dynamics damping="0.5" friction="0.05"/>
  </joint>
  <link name="l2_shield_link">
    <visual>
      <geometry>
        <mesh filename="shield.stl" scale="0.001 0.001 0.001"/>
      </geometry>
      <origin rpy="0 0 3.14" xyz="0.04 0.005 0"/>
      <material name="orange">
        <color rgba="1.0 0.5 0.0 1.0"/>
      </material>
    </visual>
    <inertial>
      <origin rpy="0 0 0" xyz="0.02928 0.00052 -0.04358"/>
      <mass value="0.0098"/>
      <inertia ixx="1.094e-05" ixy="-6.245e-10" ixz="2.948e-06" iyy="1.025e-05" iyz="-6.117e-09" izz="3.014e-06"/>
    </inertial>
  </link>
  <joint name="l2_shield_joint" type="fixed">
    <parent link="l2_tibia_link"/>
    <child link="l2_shield_link"/>
    <origin rpy="0 0 0" xyz="0.01 0 0"/>
  </joint>
  <link name="l2_micro_switch_tip_link">
    <visual>
      <geometry>
        <mesh filename="micro-switch-tip.stl" scale="0.001 0.001 0.001"/>
      </geometry>
      <origin rpy="0 0 3.14" xyz="0 0 0"/>
      <material name="orange">
        <color rgba="1.0 0.5 0.0 1.0"/>
      </material>
    </visual>
    <inertial>
      <origin rpy="0 0 0" xyz="0.00621 -0.00001 0.02072"/>
      <mass value="0.0041"/>
      <inertia ixx="1.977e-07" ixy="2.657e-11" ixz="-4.968e-08" iyy="2.338e-07" iyz="5.395e-11" izz="1.167e-07"/>
    </inertial>
  </link>
  <joint name="l2_micro_switch_tip_joint" type="fixed">
    <parent link="l2_tibia_link"/>
    <child link="l2_micro_switch_tip_link"/>
    <origin rpy="0 0 0" xyz="0.04 0 -0.13"/>
  </joint>
  <link name="l2_tip_link">
    <visual>
      <geometry>
        <mesh filename="tip.stl" scale="0.001 0.001 0.001"/>
      </geometry>
      <origin rpy="0 0 0" xyz="0 0 0"/>
      <material name="orange">
        <color rgba="1.0 0.5 0.0 1.0"/>
      </material>
    </visual>
    <collision>
      <geometry>
        <sphere radius="0.005"/>
      </geometry>
      <origin rpy="0 0 0" xyz="0 0 0"/>
    </collision>
    <inertial>
      <origin rpy="0 0 0" xyz="0.00000 -0.00000 -0.00309"/>
      <mass value="0.0018"/>
      <inertia ixx="1.069e-08" ixy="6.542e-14" ixz="-2.181e-12" iyy="1.069e-08" iyz="3.638e-12" izz="2.687e-09"/>
    </inertial>
  </link>
  <joint name="l2_tip_joint" type="fixed">
    <parent link="l2_micro_switch_tip_link"/>
    <child link="l2_tip_link"/>
    <origin rpy="0 0 0" xyz="0 0 0"/>
  </joint>
  <gazebo reference="l2_tip_link">
    <mu1>1.0</mu1>
    <mu2>1.0</mu2>
  </gazebo>
  <link name="l3_coxa_link">
    <visual>
      <geometry>
        <mesh filename="left-coxa.stl" scale="0.001 0.001 0.001"/>
      </geometry>
      <origin rpy="0 0 0" xyz="0 0 0"/>
      <material name="orange">
        <color rgba="1.0 0.5 0.0 1.0"/>
      </material>
    </visual>
    <inertial>
      <origin rpy="0 0 0" xyz="0.02964 0.00014 0.00625"/>
      <mass value="0.0771"/>
      <inertia ixx="1.617e-05" ixy="4.643e-08" ixz="6.122e-07" iyy="1.852e-05" iyz="-6.164e-08" izz="1.885e-05"/>
    </inertial>
  </link>
  <joint name="l3_coxa_joint" type="revolute">
    <parent link="base_link"/>
    <child link="l3_coxa_link"/>
    <origin rpy="0 0 -2.35" xyz="-0.06 -0.08 0.0"/>
    <axis xyz="0 0 1"/>
    <limit effort="3.4" lower="-1.57" upper="1.57" velocity="5.0"/>
    <dynamics damping="0.5" friction="0.05"/>
  </joint>
  <link name="l3_femur_link">
    <visual>
      <geometry>
        <mesh filename="left-femur.stl" scale="0.001 0.001 0.001"/>
      </geometry>
      <origin rpy="-1.57 0 0" xyz="0 0.01 0"/>
      <material name="orange">
        <color rgba="1.0 0.5 0.0 1.0"/>
      </material>
    </visual>
    <inertial>
      <origin rpy="0 0 0" xyz="0.06445 -0.00082 -0.00021"/>
      <mass value="0.0814"/>
      <inertia ixx="1.867e-05" ixy="-1.515e-06" ixz="-4.656e-07" iyy="2.912e-05" iyz="-7.096e-08" izz="4.288e-05"/>
    </inertial>
  </link>
  <joint name="l3_femur_joint" type="revolute">
    <parent link="l3_coxa_link"/>
    <child link="l3_femur_link"/>
    <origin rpy="0 -0.78 0" xyz="0.04 0 0.005"/>
    <axis xyz="0 1 0"/>
    <limit effort="3.4" lower="-1.57" upper="1.57" velocity="5.0"/>
    <dynamics damping="0.5" friction="0.05"/>
  </joint>
  <link name="l3_tibia_link">
    <visual>
      <geometry>
        <mesh filename="left-tibia.stl" scale="0.001 0.001 0.001"/>
      </geometry>
      <origin rpy="0 0 3.14" xyz="0.05 -0.005 0"/>
      <material name="orange">
        <color rgba="1.0 0.5 0.0 1.0"/>
      </material>
    </visual>
    <inertial>
      <origin rpy="0 0 0" xyz="0.02796 0.00030 -0.03451"/>
      <mass value="0.0112"/>
      <inertia ixx="1.178e-05" ixy="1.476e-07" ixz="5.850e-06" iyy="1.578e-05" iyz="-2.169e-07" izz="4.209e-06"/>
    </inertial>
  </link>
  <joint name="l3_tibia_joint" type="revolute">
    <parent link="l3_femur_link"/>
    <child link="l3_tibia_link"/>
    <origin rpy="0 0.078 0" xyz="0.08 0 0"/>
    <axis xyz="0 1 0"/>
    <limit effort="3.4" lower="-1.57" upper="1.57" velocity="5.0"/>
    <dynamics damping="0.5" friction="0.05"/>
  </joint>
  <link name="l3_shield_link">
    <visual>
      <geometry>
        <mesh filename="shield.stl" scale="0.001 0.001 0.001"/>
      </geometry>
      <origin rpy="0 0 3.14" xyz="0.04 0.005 0"/>
      <material name="orange">
        <color rgba="1.0 0.5 0.0 1.0"/>
      </material>
    </visual>
    <inertial>
      <origin rpy="0 0 0" xyz="0.02928 0.00052 -0.04358"/>
      <mass value="0.0098"/>
      <inertia ixx="1.094e-05" ixy="-6.245e-10" ixz="2.948e-06" iyy="1.025e-05" iyz="-6.117e-09" izz="3.014e-06"/>
    </inertial>
  </link>
  <joint name="l3_shield_joint" type="fixed">
    <parent link="l3_tibia_link"/>
    <child link="l3_shield_link"/>
    <origin rpy="0 0 0" xyz="0.01 0 0"/>
  </joint>
  <link name="l3_micro_switch_tip_link">
    <visual>
      <geometry>
        <mesh filename="micro-switch-tip.stl" scale="0.001 0.001 0.001"/>
      </geometry>
      <origin rpy="0 0 3.14" xyz="0 0 0"/>
      <material name="orange">
        <color rgba="1.0 0.5 0.0 1.0"/>
      </material>
    </visual>
    <inertial>
      <origin rpy="0 0 0" xyz="0.00621 -0.00001 0.02072"/>
      <mass value="0.0041"/>
      <inertia ixx="1.977e-07" ixy="2.657e-11" ixz="-4.968e-08" iyy="2.338e-07" iyz="5.395e-11" izz="1.167e-07"/>
    </inertial>
  </link>
  <joint name="l3_micro_switch_tip_joint" type="fixed">
    <parent link="l3_tibia_link"/>
    <child link="l3_micro_switch_tip_link"/>
    <origin rpy="0 0 0" xyz="0.04 0 -0.13"/>
  </joint>
  <link name="l3_tip_link">
    <visual>
      <geometry>
        <mesh filename="tip.stl" scale="0.001 0.001 0.001"/>
      </geometry>
      <origin rpy="0 0 0" xyz="0 0 0"/>
      <material name="orange">
        <color rgba="1.0 0.5 0.0 1.0"/>
      </material>
    </visual>
    <collision>
      <geometry>
        <sphere radius="0.005"/>
      </geometry>
      <origin rpy="0 0 0" xyz="0 0 0"/>
    </collision>
    <inertial>
      <origin rpy="0 0 0" xyz="0.00000 -0.00000 -0.00309"/>
      <mass value="0.0018"/>
      <inertia ixx="1.069e-08" ixy="6.542e-14" ixz="-2.181e-12" iyy="1.069e-08" iyz="3.638e-12" izz="2.687e-09"/>
    </inertial>
  </link>
  <joint name="l3_tip_joint" type="fixed">
    <parent link="l3_micro_switch_tip_link"/>
    <child link="l3_tip_link"/>
    <origin rpy="0 0 0" xyz="0 0 0"/>
  </joint>
  <gazebo reference="l3_tip_link">
    <mu1>1.0</mu1>
    <mu2>1.0</mu2>
  </gazebo>
  <link name="r1_coxa_link">
    <visual>
      <geometry>
        <mesh filename="right-coxa.stl" scale="0.001 0.001 0.001"/>
      </geometry>
      <origin rpy="0 0 0" xyz="0 0 0"/>
      <material name="orange">
        <color rgba="1.0 0.5 0.0 1.0"/>
      </material>
    </visual>
    <inertial>
      <origin rpy="0 0 0" xyz="0.02964 0.00014 0.00625"/>
      <mass value="0.0771"/>
      <inertia ixx="1.617e-05" ixy="4.643e-08" ixz="6.122e-07" iyy="1.852e-05" iyz="-6.164e-08" izz="1.885e-05"/>
    </inertial>
  </link>
  <joint name="r1_coxa_joint" type="revolute">
    <parent link="base_link"/>
    <child link="r1_coxa_link"/>
    <origin rpy="0 0 0.78" xyz="0.06 0.08 0.0"/>
    <axis xyz="0 0 1"/>
    <limit effort="3.4" lower="-1.57" upper="1.57" velocity="5.0"/>
    <dynamics damping="0.5" friction="0.05"/>
  </joint>
  <link name="r1_femur_link">
    <visual>
      <geometry>
        <mesh filename="right-femur.stl" scale="0.001 0.001 0.001"/>
      </geometry>
      <origin rpy="-1.57 0 0" xyz="0 -0.01 0"/>
      <material name="orange">
        <color rgba="1.0 0.5 0.0 1.0"/>
      </material>
    </visual>
    <inertial>
      <origin rpy="0 0 0" xyz="0.06445 -0.00082 -0.00021"/>
      <mass value="0.0814"/>
      <inertia ixx="1.867e-05" ixy="-1.515e-06" ixz="-4.656e-07" iyy="2.912e-05" iyz="-7.096e-08" izz="4.288e-05"/>
    </inertial>
  </link>
  <joint name="r1_femur_joint" type="revolute">
    <parent link="r1_coxa_link"/>
    <child link="r1_femur_link"/>
    <origin rpy="0 -0.78 0" xyz="0.04 0 0.005"/>
    <axis xyz="0 1 0"/>
    <limit effort="3.4" lower="-1.57" upper="1.57" velocity="5.0"/>
    <dynamics damping="0.5" friction="0.05"/>
  </joint>
  <link name="r1_tibia_link">
    <visual>
      <geometry>
        <mesh filename="right-tibia.stl" scale="0.001 0.001 0.001"/>
      </geometry>
      <origin rpy="0 0 3.14" xyz="0.05 0.005 0"/>
      <material name="orange">
        <color rgba="1.0 0.5 0.0 1.0"/>
      </material>
    </visual>
    <inertial>
      <origin rpy="0 0 0" xyz="0.02796 0.00030 -0.03451"/>
      <mass value="0.0112"/>
      <inertia ixx="1.178e-05" ixy="1.476e-07" ixz="5.850e-06" iyy="1.578e-05" iyz="-2.169e-07" izz="4.209e-06"/>
    </inertial>
  </link>
  <joint name="r1_tibia_joint" type="revolute">
    <parent link="r1_femur_link"/>
    <child link="r1_tibia_link"/>
    <origin rpy="0 0.078 0" xyz="0.08 0 0"/>
    <axis xyz="0 1 0"/>
    <limit effort="3.4" lower="-1.57" upper="1.57" velocity="5.0"/>
    <dynamics damping="0.5" friction="0.05"/>
  </joint>
  <link name="r1_shield_link">
    <visual>
      <geometry>
        <mesh filename="shield.stl" scale="0.001 0.001 0.001"/>
      </geometry>
      <origin rpy="0 0 3.14" xyz="0.04 0.005 0"/>
      <material name="orange">
        <color rgba="1.0 0.5 0.0 1.0"/>
      </material>
    </visual>
    <inertial>
      <origin rpy="0 0 0" xyz="0.02928 0.00052 -0.04358"/>
      <mass value="0.0098"/>
      <inertia ixx="1.094e-05" ixy="-6.245e-10" ixz="2.948e-06" iyy="1.025e-05" iyz="-6.117e-09" izz="3.014e-06"/>
    </inertial>
  </link>
  <joint name="r1_shield_joint" type="fixed">
    <parent link="r1_tibia_link"/>
    <child link="r1_shield_link"/>
    <origin rpy="0 0 0" xyz="0.01 0 0"/>
  </joint>
  <link name="r1_micro_switch_tip_link">
    <visual>
      <geometry>
        <mesh filename="micro-switch-tip.stl" scale="0.001 0.001 0.001"/>
      </geometry>
      <origin rpy="0 0 3.14" xyz="0 0 0"/>
      <material name="orange">
        <color rgba="1.0 0.5 0.0 1.0"/>
      </material>
    </visual>
    <inertial>
      <origin rpy="0 0 0" xyz="0.00621 -0.00001 0.02072"/>
      <mass value="0.0041"/>
      <inertia ixx="1.977e-07" ixy="2.657e-11" ixz="-4.968e-08" iyy="2.338e-07" iyz="5.395e-11" izz="1.167e-07"/>
    </inertial>
  </link>
  <joint name="r1_micro_switch_tip_joint" type="fixed">
    <parent link="r1_tibia_link"/>
    <child link="r1_micro_switch_tip_link"/>
    <origin rpy="0 0 0" xyz="0.04 0 -0.13"/>
  </joint>
  <link name="r1_tip_link">
    <visual>
      <geometry>
        <mesh filename="tip.stl" scale="0.001 0.001 0.001"/>
      </geometry>
      <origin rpy="0 0 0" xyz="0 0 0"/>
      <material name="orange">
        <color rgba="1.0 0.5 0.0 1.0"/>
      </material>
    </visual>
    <collision>
      <geometry>
        <sphere radius="0.005"/>
      </geometry>
      <origin rpy="0 0 0" xyz="0 0 0"/>
    </collision>
    <inertial>
      <origin rpy="0 0 0" xyz="0.00000 -0.00000 -0.00309"/>
      <mass value="0.0018"/>
      <inertia ixx="1.069e-08" ixy="6.542e-14" ixz="-2.181e-12" iyy="1.069e-08" iyz="3.638e-12" izz="2.687e-09"/>
    </inertial>
  </link>
  <joint name="r1_tip_joint" type="fixed">
    <parent link="r1_micro_switch_tip_link"/>
    <child link="r1_tip_link"/>
    <origin rpy="0 0 0" xyz="0 0 0"/>
  </joint>
  <gazebo reference="r1_tip_link">
    <mu1>1.0</mu1>
    <mu2>1.0</mu2>
  </gazebo>
  <link name="r2_coxa_link">
    <visual>
      <geometry>
        <mesh filename="right-coxa.stl" scale="0.001 0.001 0.001"/>
      </geometry>
      <origin rpy="0 0 0" xyz="0 0 0"/>
      <material name="orange">
        <color rgba="1.0 0.5 0.0 1.0"/>
      </material>
    </visual>
    <inertial>
      <origin rpy="0 0 0" xyz="0.02964 0.00014 0.00625"/>
      <mass value="0.0771"/>
      <inertia ixx="1.617e-05" ixy="4.643e-08" ixz="6.122e-07" iyy="1.852e-05" iyz="-6.164e-08" izz="1.885e-05"/>
    </inertial>
  </link>
  <joint name="r2_coxa_joint" type="revolute">
    <parent link="base_link"/>
    <child link="r2_coxa_link"/>
    <origin rpy="0 0 0" xyz="0.08 0.0 0.0"/>
    <axis xyz="0 0 1"/>
    <limit effort="3.4" lower="-1.57" upper="1.57" velocity="5.0"/>
    <dynamics damping="0.5" friction="0.05"/>
  </joint>
  <link name="r2_femur_link">
    <visual>
      <geometry>
        <mesh filename="right-femur.stl" scale="0.001 0.001 0.001"/>
      </geometry>
      <origin rpy="-1.57 0 0" xyz="0 -0.01 0"/>
      <material name="orange">
        <color rgba="1.0 0.5 0.0 1.0"/>
      </material>
    </visual>
    <inertial>
      <origin rpy="0 0 0" xyz="0.06445 -0.00082 -0.00021"/>
      <mass value="0.0814"/>
      <inertia ixx="1.867e-05" ixy="-1.515e-06" ixz="-4.656e-07" iyy="2.912e-05" iyz="-7.096e-08" izz="4.288e-05"/>
    </inertial>
  </link>
  <joint name="r2_femur_joint" type="revolute">
    <parent link="r2_coxa_link"/>
    <child link="r2_femur_link"/>
    <origin rpy="0 -0.78 0" xyz="0.04 0 0.005"/>
    <axis xyz="0 1 0"/>
    <limit effort="3.4" lower="-1.57" upper="1.57" velocity="5.0"/>
    <dynamics damping="0.5" friction="0.05"/>
  </joint>
  <link name="r2_tibia_link">
    <visual>
      <geometry>
        <mesh filename="right-tibia.stl" scale="0.001 0.001 0.001"/>
      </geometry>
      <origin rpy="0 0 3.14" xyz="0.05 0.005 0"/>
      <material name="orange">
        <color rgba="1.0 0.5 0.0 1.0"/>
      </material>
    </visual>
    <inertial>
      <origin rpy="0 0 0" xyz="0.02796 0.00030 -0.03451"/>
      <mass value="0.0112"/>
      <inertia ixx="1.178e-05" ixy="1.476e-07" ixz="5.850e-06" iyy="1.578e-05" iyz="-2.169e-07" izz="4.209e-06"/>
    </inertial>
  </link>
  <joint name="r2_tibia_joint" type="revolute">
    <parent link="r2_femur_link"/>
    <child link="r2_tibia_link"/>
    <origin rpy="0 0.078 0" xyz="0.08 0 0"/>
    <axis xyz="0 1 0"/>
    <limit effort="3.4" lower="-1.57" upper="1.57" velocity="5.0"/>
    <dynamics damping="0.5" friction="0.05"/>
  </joint>
  <link name="r2_shield_link">
    <visual>
      <geometry>
        <mesh filename="shield.stl" scale="0.001 0.001 0.001"/>
      </geometry>
      <origin rpy="0 0 3.14" xyz="0.04 0.005 0"/>
      <material name="orange">
        <color rgba="1.0 0.5 0.0 1.0"/>
      </material>
    </visual>
    <inertial>
      <origin rpy="0 0 0" xyz="0.02928 0.00052 -0.04358"/>
      <mass value="0.0098"/>
      <inertia ixx="1.094e-05" ixy="-6.245e-10" ixz="2.948e-06" iyy="1.025e-05" iyz="-6.117e-09" izz="3.014e-06"/>
    </inertial>
  </link>
  <joint name="r2_shield_joint" type="fixed">
    <parent link="r2_tibia_link"/>
    <child link="r2_shield_link"/>
    <origin rpy="0 0 0" xyz="0.01 0 0"/>
  </joint>
  <link name="r2_micro_switch_tip_link">
    <visual>
      <geometry>
        <mesh filename="micro-switch-tip.stl" scale="0.001 0.001 0.001"/>
      </geometry>
      <origin rpy="0 0 3.14" xyz="0 0 0"/>
      <material name="orange">
        <color rgba="1.0 0.5 0.0 1.0"/>
      </material>
    </visual>
    <inertial>
      <origin rpy="0 0 0" xyz="0.00621 -0.00001 0.02072"/>
      <mass value="0.0041"/>
      <inertia ixx="1.977e-07" ixy="2.657e-11" ixz="-4.968e-08" iyy="2.338e-07" iyz="5.395e-11" izz="1.167e-07"/>
    </inertial>
  </link>
  <joint name="r2_micro_switch_tip_joint" type="fixed">
    <parent link="r2_tibia_link"/>
    <child link="r2_micro_switch_tip_link"/>
    <origin rpy="0 0 0" xyz="0.04 0 -0.13"/>
  </joint>
  <link name="r2_tip_link">
    <visual>
      <geometry>
        <mesh filename="tip.stl" scale="0.001 0.001 0.001"/>
      </geometry>
      <origin rpy="0 0 0" xyz="0 0 0"/>
      <material name="orange">
        <color rgba="1.0 0.5 0.0 1.0"/>
      </material>
    </visual>
    <collision>
      <geometry>
        <sphere radius="0.005"/>
      </geometry>
      <origin rpy="0 0 0" xyz="0 0 0"/>
    </collision>
    <inertial>
      <origin rpy="0 0 0" xyz="0.00000 -0.00000 -0.00309"/>
      <mass value="0.0018"/>
      <inertia ixx="1.069e-08" ixy="6.542e-14" ixz="-2.181e-12" iyy="1.069e-08" iyz="3.638e-12" izz="2.687e-09"/>
    </inertial>
  </link>
  <joint name="r2_tip_joint" type="fixed">
    <parent link="r2_micro_switch_tip_link"/>
    <child link="r2_tip_link"/>
    <origin rpy="0 0 0" xyz="0 0 0"/>
  </joint>
  <gazebo reference="r2_tip_link">
    <mu1>1.0</mu1>
    <mu2>1.0</mu2>
  </gazebo>
  <link name="r3_coxa_link">
    <visual>
      <geometry>
        <mesh filename="right-coxa.stl" scale="0.001 0.001 0.001"/>
      </geometry>
      <origin rpy="0 0 0" xyz="0 0 0"/>
      <material name="orange">
        <color rgba="1.0 0.5 0.0 1.0"/>
      </material>
    </visual>
    <inertial>
      <origin rpy="0 0 0" xyz="0.02964 0.00014 0.00625"/>
      <mass value="0.0771"/>
      <inertia ixx="1.617e-05" ixy="4.643e-08" ixz="6.122e-07" iyy="1.852e-05" iyz="-6.164e-08" izz="1.885e-05"/>
    </inertial>
  </link>
  <joint name="r3_coxa_joint" type="revolute">
    <parent link="base_link"/>
    <child link="r3_coxa_link"/>
    <origin rpy="0 0 -0.78" xyz="0.06 -0.08 0.0"/>
    <axis xyz="0 0 1"/>
    <limit effort="3.4" lower="-1.57" upper="1.57" velocity="5.0"/>
    <dynamics damping="0.5" friction="0.05"/>
  </joint>
  <link name="r3_femur_link">
    <visual>
      <geometry>
        <mesh filename="right-femur.stl" scale="0.001 0.001 0.001"/>
      </geometry>
      <origin rpy="-1.57 0 0" xyz="0 -0.01 0"/>
      <material name="orange">
        <color rgba="1.0 0.5 0.0 1.0"/>
      </material>
    </visual>
    <inertial>
      <origin rpy="0 0 0" xyz="0.06445 -0.00082 -0.00021"/>
      <mass value="0.0814"/>
      <inertia ixx="1.867e-05" ixy="-1.515e-06" ixz="-4.656e-07" iyy="2.912e-05" iyz="-7.096e-08" izz="4.288e-05"/>
    </inertial>
  </link>
  <joint name="r3_femur_joint" type="revolute">
    <parent link="r3_coxa_link"/>
    <child link="r3_femur_link"/>
    <origin rpy="0 -0.78 0" xyz="0.04 0 0.005"/>
    <axis xyz="0 1 0"/>
    <limit effort="3.4" lower="-1.57" upper="1.57" velocity="5.0"/>
    <dynamics damping="0.5" friction="0.05"/>
  </joint>
  <link name="r3_tibia_link">
    <visual>
      <geometry>
        <mesh filename="right-tibia.stl" scale="0.001 0.001 0.001"/>
      </geometry>
      <origin rpy="0 0 3.14" xyz="0.05 0.005 0"/>
      <material name="orange">
        <color rgba="1.0 0.5 0.0 1.0"/>
      </material>
    </visual>
    <inertial>
      <origin rpy="0 0 0" xyz="0.02796 0.00030 -0.03451"/>
      <mass value="0.0112"/>
      <inertia ixx="1.178e-05" ixy="1.476e-07" ixz="5.850e-06" iyy="1.578e-05" iyz="-2.169e-07" izz="4.209e-06"/>
    </inertial>
  </link>
  <joint name="r3_tibia_joint" type="revolute">
    <parent link="r3_femur_link"/>
    <child link="r3_tibia_link"/>
    <origin rpy="0 0.078 0" xyz="0.08 0 0"/>
    <axis xyz="0 1 0"/>
    <limit effort="3.4" lower="-1.57" upper="1.57" velocity="5.0"/>
    <dynamics damping="0.5" friction="0.05"/>
  </joint>
  <link name="r3_shield_link">
    <visual>
      <geometry>
        <mesh filename="shield.stl" scale="0.001 0.001 0.001"/>
      </geometry>
      <origin rpy="0 0 3.14" xyz="0.04 0.005 0"/>
      <material name="orange">
        <color rgba="1.0 0.5 0.0 1.0"/>
      </material>
    </visual>
    <inertial>
      <origin rpy="0 0 0" xyz="0.02928 0.00052 -0.04358"/>
      <mass value="0.0098"/>
      <inertia ixx="1.094e-05" ixy="-6.245e-10" ixz="2.948e-06" iyy="1.025e-05" iyz="-6.117e-09" izz="3.014e-06"/>
    </inertial>
  </link>
  <joint name="r3_shield_joint" type="fixed">
    <parent link="r3_tibia_link"/>
    <child link="r3_shield_link"/>
    <origin rpy="0 0 0" xyz="0.01 0 0"/>
  </joint>
  <link name="r3_micro_switch_tip_link">
    <visual>
      <geometry>
        <mesh filename="micro-switch-tip.stl" scale="0.001 0.001 0.001"/>
      </geometry>
      <origin rpy="0 0 3.14" xyz="0 0 0"/>
      <material name="orange">
        <color rgba="1.0 0.5 0.0 1.0"/>
      </material>
    </visual>
    <inertial>
      <origin rpy="0 0 0" xyz="0.00621 -0.00001 0.02072"/>
      <mass value="0.0041"/>
      <inertia ixx="1.977e-07" ixy="2.657e-11" ixz="-4.968e-08" iyy="2.338e-07" iyz="5.395e-11" izz="1.167e-07"/>
    </inertial>
  </link>
  <joint name="r3_micro_switch_tip_joint" type="fixed">
    <parent link="r3_tibia_link"/>
    <child link="r3_micro_switch_tip_link"/>
    <origin rpy="0 0 0" xyz="0.04 0 -0.13"/>
  </joint>
  <link name="r3_tip_link">
    <visual>
      <geometry>
        <mesh filename="tip.stl" scale="0.001 0.001 0.001"/>
      </geometry>
      <origin rpy="0 0 0" xyz="0 0 0"/>
      <material name="orange">
        <color rgba="1.0 0.5 0.0 1.0"/>
      </material>
    </visual>
    <collision>
      <geometry>
        <sphere radius="0.005"/>
      </geometry>
      <origin rpy="0 0 0" xyz="0 0 0"/>
    </collision>
    <inertial>
      <origin rpy="0 0 0" xyz="0.00000 -0.00000 -0.00309"/>
      <mass value="0.0018"/>
      <inertia ixx="1.069e-08" ixy="6.542e-14" ixz="-2.181e-12" iyy="1.069e-08" iyz="3.638e-12" izz="2.687e-09"/>
    </inertial>
  </link>
  <joint name="r3_tip_joint" type="fixed">
    <parent link="r3_micro_switch_tip_link"/>
    <child link="r3_tip_link"/>
    <origin rpy="0 0 0" xyz="0 0 0"/>
  </joint>
  <gazebo reference="r3_tip_link">
    <mu1>1.0</mu1>
    <mu2>1.0</mu2>
  </gazebo>
  <ros2_control name="GazeboSimSystem" type="system">
    <hardware>
      <plugin>gz_ros2_control/GazeboSimSystem</plugin>
    </hardware>
    <joint name="l1_coxa_joint">
      <command_interface name="position"/>
      <state_interface name="position"/>
      <state_interface name="velocity"/>
      <state_interface name="effort"/>
    </joint>
    <joint name="l1_femur_joint">
      <command_interface name="position"/>
      <state_interface name="position"/>
      <state_interface name="velocity"/>
      <state_interface name="effort"/>
    </joint>
    <joint name="l1_tibia_joint">
      <command_interface name="position"/>
      <state_interface name="position"/>
      <state_interface name="velocity"/>
      <state_interface name="effort"/>
    </joint>
    <joint name="l2_coxa_joint">
      <command_interface name="position"/>
      <state_interface name="position"/>
      <state_interface name="velocity"/>
      <state_interface name="effort"/>
    </joint>
    <joint name="l2_femur_joint">
      <command_interface name="position"/>
      <state_interface name="position"/>
      <state_interface name="velocity"/>
      <state_interface name="effort"/>
    </joint>
    <joint name="l2_tibia_joint">
      <command_interface name="position"/>
      <state_interface name="position"/>
      <state_interface name="velocity"/>
      <state_interface name="effort"/>
    </joint>
    <joint name="l3_coxa_joint">
      <command_interface name="position"/>
      <state_interface name="position"/>
      <state_interface name="velocity"/>
      <state_interface name="effort"/>
    </joint>
    <joint name="l3_femur_joint">
      <command_interface name="position"/>
      <state_interface name="position"/>
      <state_interface name="velocity"/>
      <state_interface name="effort"/>
    </joint>
    <joint name="l3_tibia_joint">
      <command_interface name="position"/>
      <state_interface name="position"/>
      <state_interface name="velocity"/>
      <state_interface name="effort"/>
    </joint>
    <joint name="r1_coxa_joint">
      <command_interface name="position"/>
      <state_interface name="position"/>
      <state_interface name="velocity"/>
      <state_interface name="effort"/>
    </joint>
    <joint name="r1_femur_joint">
      <command_interface name="position"/>
      <state_interface name="position"/>
      <state_interface name="velocity"/>
      <state_interface name="effort"/>
    </joint>
    <joint name="r1_tibia_joint">
      <command_interface name="position"/>
      <state_interface name="position"/>
      <state_interface name="velocity"/>
      <state_interface name="effort"/>
    </joint>
    <joint name="r2_coxa_joint">
      <command_interface name="position"/>
      <state_interface name="position"/>
      <state_interface name="velocity"/>
      <state_interface name="effort"/>
    </joint>
    <joint name="r2_femur_joint">
      <command_interface name="position"/>
      <state_interface name="position"/>
      <state_interface name="velocity"/>
      <state_interface name="effort"/>
    </joint>
    <joint name="r2_tibia_joint">
      <command_interface name="position"/>
      <state_interface name="position"/>
      <state_interface name="velocity"/>
      <state_interface name="effort"/>
    </joint>
    <joint name="r3_coxa_joint">
      <command_interface name="position"/>
      <state_interface name="position"/>
      <state_interface name="velocity"/>
      <state_interface name="effort"/>
    </joint>
    <joint name="r3_femur_joint">
      <command_interface name="position"/>
      <state_interface name="position"/>
      <state_interface name="velocity"/>
      <state_interface name="effort"/>
    </joint>
    <joint name="r3_tibia_joint">
      <command_interface name="position"/>
      <state_interface name="position"/>
      <state_interface name="velocity"/>
      <state_interface name="effort"/>
    </joint>
  </ros2_control>
  <gazebo>
    <plugin filename="libgz_ros2_control-system.so" name="gz_ros2_control::GazeboSimROS2ControlPlugin">
      <parameters>/home/hexapod/hexapod/hexapod_ws/install/hexapod_description/share/hexapod_description/config/controllers.yaml</parameters>
    </plugin>
  </gazebo>
</robot>
