pro7it/hexapod/(commit log)

2026-09-18 add: main stl parts
    [battery-bar.stl, bottom-cover.stl, calibration-arm.stl, calibration-ruler.stl, frame.stl, top-cover.stl]
2026-09-18 add: legs components
    [left-coxa.stl, left-femur.stl, left-tibia.stl, limiter.stl, micro-switch-tip.stl, right-coxa.stl, right-femur.stl, right-tibia.stl]
2026-10-15 add: base urdf and rviz2 visualization
2026-10-15 rm: physics in urdf
2026-10-15 rm: physics in urdf 2.0
2026-10-22 model and sensors done
2026-10-31 stage2 ready, now calibrating
2026-11-04 +2mm to coxa and femur
